tmcit-ararobo-2026a/logic-power-management-board/README.md

# <リポジトリ名>

<!-- 一行でプロジェクトを説明する -->

## 目次

1. [概要](#1-概要)
2. [ドキュメント](#2-ドキュメント)
3. [ビルド・使い方](#3-ビルド使い方)
4. [システム構成](#4-システム構成)
5. [ライセンス](#5-ライセンス)

## 1. 概要

<!-- プロジェクトの目的・背景・解決する課題を記述 -->

## 2. ドキュメント

| ドキュメント | 説明 |
| :-: | :-: |
| [CONTRIBUTING.md](./CONTRIBUTING.md) | 開発フロー・コミット規約・コーディング規約 |
| [docs/coding-rules.md](./docs/coding-rules.md) | コーディング規約の詳細 |
| [docs/uml/](./docs/uml/) | UML図 |

## 3. ビルド・使い方

<!-- ビルドのやり方 -->
<!-- 使い方 -->

## 4. システム構成

<!-- ROS2ノード構成・STM32との通信方式・ハードウェア構成 等 -->
<!-- 依存クラスが3つ以上ある場合は docs/uml/ にUML図を作成し、ここにリンクする -->

## 5. ライセンス

本リポジトリは [MITライセンス](./LICENSE) のもとで公開されています。
