tmcit-ararobo-2026a/logic-power-management-board/switchboard/switchboard.kicad_pcb

## KiCad design switchboard/switchboard.kicad_pcb (2026-04-25)

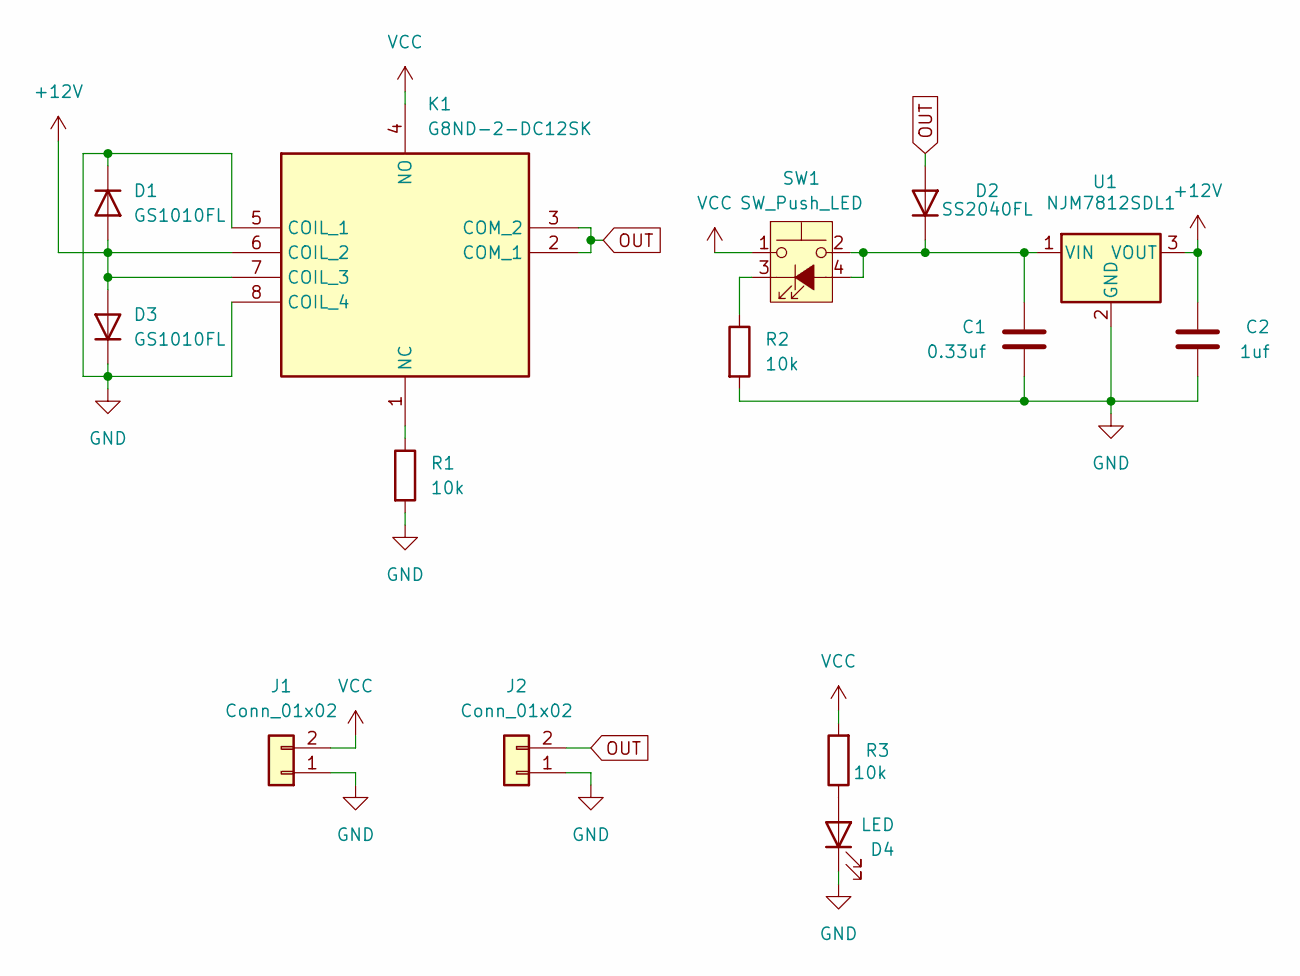
[picture p4: schematic switchboard.kicad_sch]

Parts:
C1: 0.33uf; C_0603_1608Metric_Pad1.08x0.95mm_HandSolder
C2: 1uf; C_0603_1608Metric_Pad1.08x0.95mm_HandSolder
D1, D3: GS1010FL; SOD-123FL
D2: SS2040FL; SOD-123FL
D4: LED; LED_0603_1608Metric_Pad1.05x0.95mm_HandSolder
J1: Conn_01x02; AMASS_XT60PW-M_1x02_P7.20mm_Horizontal
J2: Conn_01x02; AMASS_XT60PW-F_1x02_P7.20mm_Horizontal
K1: G8ND-2-DC12SK; G8ND2DC12SK; Mouser Part Number 653-G8ND-2-DC12SK
R1, R2, R3: 10k; R_0603_1608Metric_Pad0.98x0.95mm_HandSolder
SW1: SW_Push_LED; LS601-CRwithCAP
U1: NJM7812SDL1; TO-252-2

Connections:
+12V: C2.1, D1.2 (A), D3.2 (A), K1.6 (COIL_2), K1.7 (COIL_3), U1.3 (VOUT)
GND: C1.2, C2.2, D1.1 (K), D3.1 (K), D4.1 (K), J1.1, J2.1, K1.5 (COIL_1), K1.8 (COIL_4), R1.2, R2.2, U1.2 (GND)
unnamed: C1.1, D2.1 (K), SW1.2, SW1.4 (A), U1.1 (VIN)
unnamed: D4.2 (A), R3.1
unnamed: K1.1 (NC), R1.1
unnamed: R2.1, SW1.3 (K)
OUT: D2.2 (A), J2.2, K1.2 (COM_1), K1.3 (COM_2)
VCC: J1.2, K1.4 (NO), R3.2, SW1.1

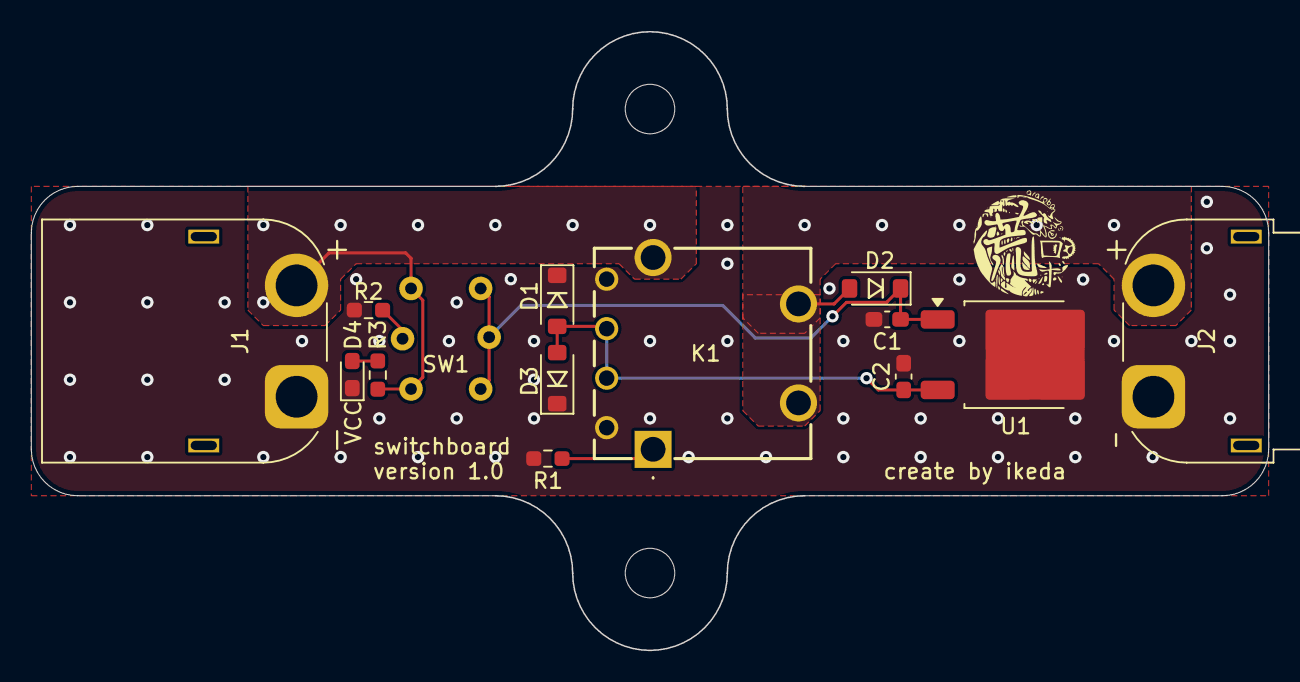
[picture p5: board switchboard.kicad_pcb from above]

Board: 2 copper layers, 80.0 x 40.0 mm, 14 parts (0 on the bottom side), 8 nets.
