tmcit-ararobo-2026a/logic-power-management-board/logic-power-management-board.ioc

Mcu.UserName=STM32G431K8Tx
PA0.GPIO_Label=ADC_CH1
PA0.Signal=ADC1_IN1
PA1.GPIO_Label=ADC_CH2
PA1.Signal=ADC1_IN2
PA11.Signal=FDCAN1_RX
PA12.Signal=FDCAN1_TX
PA13.Signal=SYS_JTMS-SWDIO
PA14.Signal=SYS_JTCK-SWCLK
PA2.GPIO_Label=ADC_CH3
PA2.Signal=ADC1_IN3
PA3.GPIO_Label=ADC_CH4
PA3.Signal=ADC1_IN4
PA4.GPIO_Label=LED1
PA4.Signal=GPIO_Output
PA5.GPIO_Label=LED2
PA5.Signal=GPIO_Output
PA6.GPIO_Label=LED3
PA6.Signal=GPIO_Output
PA7.GPIO_Label=LED4
PA7.Signal=GPIO_Output
PB6.Signal=USART1_TX
PB7.Signal=USART1_RX
