tmcit-ararobo-2026a/logic-power-management-board/Core/Inc/main.h

#define ADC_CH1_Pin GPIO_PIN_0
#define ADC_CH1_GPIO_Port GPIOA
#define ADC_CH2_Pin GPIO_PIN_1
#define ADC_CH2_GPIO_Port GPIOA
#define ADC_CH3_Pin GPIO_PIN_2
#define ADC_CH3_GPIO_Port GPIOA
#define ADC_CH4_Pin GPIO_PIN_3
#define ADC_CH4_GPIO_Port GPIOA
#define LED1_Pin GPIO_PIN_4
#define LED1_GPIO_Port GPIOA
#define LED2_Pin GPIO_PIN_5
#define LED2_GPIO_Port GPIOA
#define LED3_Pin GPIO_PIN_6
#define LED3_GPIO_Port GPIOA
#define LED4_Pin GPIO_PIN_7
#define LED4_GPIO_Port GPIOA
