tmcit-ararobo-2026a/logic-power-management-board/(commit log)

2026-04-18 回路図完成
    [logic-power-management-board.kicad_pcb, logic-power-management-board.kicad_sch]
2026-04-18 FETの向きが逆だったので修正
    [logic-power-management-board.kicad_sch]
2026-04-19 PCB完成(ビア、シルクを除く)
    [logic-power-management-board.kicad_pcb, logic-power-management-board.kicad_sch]
2026-04-19 コンデンサー追加、シルク修正
    [logic-power-management-board.kicad_pcb, logic-power-management-board.kicad_sch]
2026-04-22 switchboardの追加
    [demo.kicad_pcb, demo.kicad_sch, switchboard.kicad_pcb, switchboard.kicad_sch]
2026-04-25 ガーバ生成
    [bom.csv, designators.csv, logic-power-management-board.kicad_pcb, positions.csv, switchboard.kicad_pcb]
2026-04-25 配線、ビアの修正
    [logic-power-management-board.kicad_pcb]
2026-07-01 fix : 生成する場所間違えた
2026-07-13 feat : 電源を監視することができるようになった
2026-09-01 fix:ディレクトリ配置修正
2026-09-01 feat:gn10-can更新＆ドライバをメイン基板と一致
2026-09-01 feat:クラス化する必要がない箇所を削り、appのリネーム
2026-09-01 feat:adc設定の見直しとcan通信のseg調整
2026-09-03 feat:電圧取得
2026-09-03 feat:gn10-can更新
2026-09-03 feat:gn10-canを更新し、Voltageメッセージを使った
2026-09-03 feat:CAN受信にヘルパー関数使用
2026-09-03 feat:CANDriverライブラリ追加
2026-09-09 feat:分解能をfloat化、書き込み用タスク追加
2026-09-10 feat:実際の基板似合わせて調整
2026-09-14 fix:謎の補正削除
